JackLiu00331/CDRLCArduino/(commit log)

2026-04-24 Initial commit: reorganize project into src/ layout
    - src/Arduino/{master_node,ui_node,wing_a,wing_b} – Arduino sketches
    - src/server/ – Python room server and utilities
    - src/docker/ – Dockerfile, docker-compose, nginx, Tailscale config
    - src/test/ – I2C ping tools and integration test sketches
    - src/ – PDF milestone report
    - Root – README.md, CDRLC_Final_Report.md, .gitignore
2026-04-24 feat: add 16x2 LCD fallback master node (v5.1-LCD)
    Adds src/Arduino/master_node_lcd/master_node_lcd.ino as a
    development/fallback build while the Hosyond 4" TFT screen is
    not yet available.
    Functional parity with TFT v5.0:
    - Same WiFi + HTTPS server polling (5-min auto, BTN2 manual)
    - Same I2C master: Wing A (0x09), Wing B (0x0A), DHT11 (0x08)
    - Same 3-button control: slot cycle / refresh / date cycle
    - Same non-blocking buzzer alert on room-becomes-free
    Display differences (16x2 LCD, no touch, no QR):
    - Line 1: "MM/DD HHMM ##.#C" (date, slot, temperature)
    - Line 2: auto-cycles 4 pages of 2 rooms every 2.5 s
    e.g. "2432:F 2434:B "
    LCD pins: RS=D7, EN=D9, D4=D10, D5=D11, D6=D12, D7=D13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
    [master_node_lcd.ino]
2026-04-24 fix: slot cache, today snapshot, and weekend date expansion
    Fix 1 – Arduino local slot cache (master_node + master_node_lcd):
    • Add cachedSlots[5][8][9] + slotCached[5][8] arrays
    • Extract applySlotData() to share LED/display update logic
    • fetchAndDisplay() checks cache first; only fetches from server on miss
    • lastAutoFetch timer only resets on real network fetch (not cache hits)
    • BTN2 clears entire cache before /refresh so all slots re-fetch fresh
    • Auto-refresh invalidates current slot only; other slots stay instant
    • fetchDates() clears cache whenever date list is rebuilt
    Fix 2 – Server day snapshot (room_server.py):
    • After each refresh_all(), save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
    [master_node.ino, master_node_lcd.ino, ui_node.ino]
2026-04-24 ux: add loading indicators to LCD build (v5.1-LCD)
    - Show "MM/DD HHMM ..." + "Fetching data..." on cache miss before
    blocking HTTP call so user knows the screen is working, not frozen
    - Show "Network error!" for 1.5 s on HTTP failure then restore data
    - BTN2 (manual refresh): also update line 1 to "Please wait..."
    - pendingRefresh wait: show "Getting dates..." before fetchDates()
    - lcdPageTick() frozen during pendingRefresh to avoid overwriting messages
    - setup(): show "Getting dates..." before first fetchDates() call
    [master_node_lcd.ino]
2026-04-24 ux: add loading indicators and error states to TFT build (v5.0)
    - Add drawHeaderWithBadge(): redraws header with custom status badge
    (e.g. "loading...", "refreshing...", "error!") while keeping date/slot
    context visible — user always knows what they are waiting for
    - Add drawContentStatus(): fills only the room-list area with a centred
    big+small message; header stays untouched
    - Cache miss → drawHeaderWithBadge("loading...")+drawContentStatus before
    blocking HTTP call so screen never silently freezes
    - Network error → dark-red overlay "Network Error / Showing last known data"
    for 2 s, then restore previous room data via drawNormalScreen()
    - BTN2: show "Refreshing from server.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
    [master_node.ino]
2026-04-25 fix: correct TFT driver IC from ST7796S to ILI9486
    Display is Hosyond 4.0" with ILI9486 (not ST7796S as previously assumed).
    Key User_Setup.h changes that affect hardware behaviour:
    - #define ILI9486_DRIVER (was ST7796_DRIVER)
    - TFT_RGB_ORDER TFT_BGR (ILI9486 sends Blue before Red; ST7796S was RGB)
    - SPI_FREQUENCY 20000000 (lowered from 27 MHz; ILI9486 SPI more conservative)
    - Added #define TFT_INVERSION_ON note for modules with inverted display
    Also updated all references in master_node.ino, master_node_lcd.ino,
    README.md, and CDRLC_Final_Report.md (driver name + datasheet attribution).
    [User_Setup.h, master_node.ino, master_node_lcd.ino]
2026-04-25 revert: restore ST7796S driver (ILI9486 was incorrect)
    Reverts commit e2927e5. The display is confirmed ST7796S, not ILI9486.
    Restores User_Setup.h to ST7796_DRIVER, SPI 27 MHz, TFT_RGB colour order,
    and updates all comments and documentation references accordingly.
    [User_Setup.h, master_node.ino, master_node_lcd.ino]
2026-04-25 fix: persist day_snapshot.json across container rebuilds
    Add volume mount for day_snapshot.json so the date snapshot
    data survives docker compose up --build. Without this, the
    server loses all cached future-date availability on every
    image rebuild and must wait for the next refresh cycle.
    Requires creating an empty file on the host before first run:
    echo "{}" > day_snapshot.json
2026-04-25 fix: QR generation failure and flicker on TFT build
    - Bump QR version 9 → 10 (byte capacity 154 → 174); our ~140-char
    Google Calendar URLs were at the edge of V9's limit under stack
    pressure from SSL/TFT SRAM usage on the R4 WiFi
    - Declare qrData[] as static (global memory) instead of a local stack
    variable to avoid stack overflow when WiFi+TFT already fill SRAM
    - On generation failure: show a readable 2-second error message, then
    reset dispState to DISP_NORMAL and call drawNormalScreen() — prevents
    the flicker loop where every subsequent touch re-triggered drawQRScreen
    [master_node.ino]
2026-04-25 fix: touch flicker between QR and Normal screens
    Add touchMustRelease flag: after any QR↔Normal state transition, all
    touch events are ignored until ts.touched() returns false (finger lifted).
    Previously, a single tap could fire two actions in quick succession:
    1. touch in Normal mode → dispState=DISP_QR (drawQRScreen renders)
    2. same finger still down → fires again in DISP_QR → dispState=DISP_NORMAL
    3. same finger still down → fires again at 479,319 which maps to row 7
    (Room 2430) → dispState=DISP_QR again → infinite flicker loop
    The wait-for-release approach is more robust than a simple cooldown because
    it is independent of rendering time and screen response late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
    [master_node.ino]
2026-04-25 fix: replace direct Google URL QR with server short-link QR
    The qrcode library consistently failed to generate Version 10 QR codes
    for our ~140-char Google Calendar URLs on the R4 WiFi (likely a memory
    or library-version limitation that is hard to diagnose without the exact
    installed library source).
    New approach: use the server's existing /newbook + /b/<CODE> short-link
    infrastructure instead of encoding the full Google URL directly.
    Flow:
    1. User taps a free room row
    2. drawQRScreen() shows "Getting booking link..." loading screen
    3. Arduino calls GET /newbook?date=...&time=...
    4. Server returns a 6-char code (e.g. "A1B2C3")
    5. Short URL built: https://<SERVER>/b/A1B2C3 (~45 c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
    [master_node.ino]
2026-04-25 fix: QR now uses Google Calendar URL directly with correct library return value
    Key fixes:
    - Reverted to direct GCAL_URLS[] encoding (no server /newbook call needed)
    - Fixed root cause: ricmoo qrcode_initText returns 0 on success (C convention),
    not 1; casting to bool was inverting the result, causing false failures
    - Use qrc.size > 0 as the reliable success check instead of return value
    - QR Version 7 (45x45, 154-byte ECC_LOW capacity) handles ~140-char URLs
    - Added button debug logging: BTN1/D4 logs slotIdx change, BTN3/D6 logs dateIdx
    - QR renders instantly (no network round-trip)
    [master_node.ino]
2026-04-25 feat: today's date shows snapshot data without Book button; fix Friday date list
    Server (room_server.py):
    - valid_dates() now splits Fri vs Sat-Sun:
    Fri → [today (snapshot), next Mon–Thu] (5 dates, fits dateList[5])
    Sat-Sun → [next Mon–Fri] (unchanged)
    Mon-Thu unchanged (today through Fri of this week)
    Arduino (master_node.ino):
    - Added todayDate[9] global, computed from NTP epoch after WiFi connect
    - drawNormalScreen(): today's free rooms show "Free" (accent green, no pill)
    instead of "Book >" — visually distinguishable, not interactive
    - handleTouch(): tapping a room row is ignored when showing today's date,
    preventing a useless QR for a slot that Google Calendar wil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
    [master_node.ino]
2026-04-25 feat: prefetch all dates×slots at startup for instant navigation
    - Add GET /allslots?date=YYYYMMDD endpoint
    Returns all 8 slot strings comma-separated in one response (~71 chars)
    e.g. "10010100,11111111,00000000,..."
    5 requests covers all 40 slots (vs 40 individual /slot calls before)
    - Add prefetchAllDates(): fetches /allslots for every available date,
    parses and fills cachedSlots[d][s] + slotCached[d][s] for all d,s
    Shows "Mon 04/27 (1/5)" progress overlay during load
    Resets lastAutoFetch timer on completion
    - setup(): call prefetchAllDates() after fetchDates(); fetchAndDisplay()
    is then always a cache hit — no post-boo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
    [master_node.ino]
2026-04-25 fix: always consume HTTP response body to keep keep-alive connection clean
    httpGet() was returning early on non-200 status without reading the body.
    This left stale bytes in the SSL socket, corrupting the next request on
    the same keep-alive connection (manifested as Network Error on /slot after
    multiple failed /allslots 404 responses from an outdated server image).
    Now always reads responseBody() before checking status code.
    [master_node.ino]
2026-04-25 refactor: remove unused booking session code from room_server.py (v4.2)
    Arduino now generates QR codes directly from hard-coded Google Calendar URLs,
    so the entire server-side booking flow is no longer needed.
    Removed:
    - import secrets
    - BOOK_BASE_URL constant
    - GCAL_BOOK_URLS dict (URLs now live only in Arduino flash)
    - booking_sessions dict + sessions_lock + SESSION_TTL
    - make_code() and cleanup_sessions() helpers
    - booking_page_html() function (~90 lines of HTML template)
    - /newbook endpoint (Arduino no longer calls it)
    - /b/<CODE> endpoint (phone booking page removed)
    - reply_html() method (only used by /b/<CODE>)
    Kept:
    - /hotslots + get_hot_slots() (used by /status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
2026-04-25 fix: validate date and time parameters in slot request
2026-04-25 fix: allow /allslots through nginx and harden date validation
    - nginx.conf: add allslots to the location regex so requests reach
    the Python server (was 404'd before). Also remove the now-deleted
    newbook and b/.+ routes.
    - room_server.py: add .isdigit() guard on /allslots date param,
    matching the same validation already on /slot.
2026-04-25 feat: move HC-SR04 to master_node for TFT backlight auto-dim
    - master_node: add HC-SR04 on D2(Trig)/D7(Echo), TFT backlight on
    D3(PWM). updateBacklight() checks distance every 200ms — dims screen
    to 30/255 when no one within 100cm, restores 255 when someone approaches.
    - wing_b: remove HC-SR04 entirely (sensor now lives on master_node).
    LEDs run at fixed brightness 200. Simplifies wing_b significantly.
    [master_node.ino, wing_b.ino]
2026-04-26 feat: activity-based backlight with smooth fade and auto-off
    Replace simple on/off proximity backlight with a proper idle timer:
    - Any activity (proximity / touch / button) → immediate full brightness
    and resets the 30-second idle clock.
    - 10–13 s idle: smooth 3-second linear fade to dim (40/255).
    - 13–30 s idle: hold at dim — screen readable but unobtrusive.
    - 30 s+ idle: screen off completely (0/255).
    - Touch while screen is off: wake only, no booking action triggered.
    [master_node.ino]
2026-04-26 feat: add TM1637 4-digit + 74HC595 1-digit displays on Arduino 2
    ui_node (Arduino 2):
    - TM1637 4-digit display on D3/D4 shows current time slot (e.g. 09:30)
    with colon lit. Bit-banged driver, no extra library needed.
    - 74HC595 + 1-digit 7-seg on D5/D6/D7 shows free room count (0-8).
    - New Wire.onReceive() handler accepts 2-byte packet [freeCount, slotIdx]
    from master and updates both displays immediately.
    - Startup shows "----" / "-" until first data arrives from master.
    - DHT11 read and I2C requestEvent unchanged.
    master_node (Arduino 1):
    - New sendDisplayData(): counts free rooms from roomFree[], then sends
    [freeCount, slotIdx] to Arduino 2 (0x08) via I2C write.
    - Called at the end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
2026-04-26 fix: update 7-seg driver for 5161AS common-anode display
    - SEG7[] patterns inverted (active-low for common anode)
    - shiftOut changed from MSBFIRST to LSBFIRST so bit0→QA→segment-a
    - Startup dash corrected to 0xBF (~0x40, g-segment only)
    - Wiring comment updated: COM pins → 5V, each segment → 220Ω → QA-QG
    [ui_node.ino]
2026-04-26 refactor: remove TM1637, keep only 5161AS 1-digit display
    Space only allows one 7-seg. Free room count (0-8) gives more
    at-a-glance value than time slot which is already on the TFT.
    Simplifies ui_node: no TM1637 pins/driver/slot-digit table.
2026-04-26 refactor: drive 5161AS directly without 74HC595
    ui_node has plenty of free pins — no shift register needed.
    7 segment pins connect directly to D3-D9 via 220Ω resistors.
    Code simplifies to plain digitalWrite(), no shiftOut().
2026-04-26 fix: switch 7-seg to common cathode (COM→GND, segments active-HIGH)
    [ui_node.ino]
2026-04-26 feat: centralize LDR to master_node, broadcast brightness to all 8 LEDs
    - master_node: read LDR on A2 each loop tick, cache as ledBrightness.
    sendI2C() extended from 3 to 4 bytes: [ctrl, data, brightness, checksum].
    - wing_a: remove local LDR. receiveEvent() now reads 4-byte packet and
    stores brightness from master. All 5 LEDs use master-controlled brightness.
    - wing_b: same 4-byte protocol. All 3 LEDs now follow ambient light instead
    of fixed value 200.
    All 8 LEDs across both wings now dim/brighten identically.
    [master_node.ino, wing_a.ino, wing_b.ino]
2026-04-26 calibrate: adjust LDR map range to measured values (102–850)
    Based on actual hardware readings:
    102 = finger pressed (darkest) → LED brightness 40
    375 = dim bedroom → LED brightness ~120
    850 = flashlight direct → LED brightness 255
2026-04-26 feat: LEDs follow screen sleep state + remove debug logs
    - sendI2C() now sends brightness=0 when screen is BL_OFF, so all wing
    LEDs go dark when the 30s idle timer fires (same moment as screen off).
    - markActive() resends current status to both wings immediately on wake,
    so LEDs and screen light up together on any activity.
    - Periodic 1s brightness sync renamed lastBrightnessSync (was lastLDRPrint).
    - Removed all test Serial.print logs from wing_a, wing_b receiveEvent.
    - Removed Serial.begin(9600) from wing_a and wing_b setup.
2026-04-26 fix: turn off red LEDs when brightness=0 (sleep mode)
    Red LEDs use digitalWrite so they ignore the brightness value.
    When master sends brightness=0 (screen off), explicitly drive all
    red pins LOW so every LED goes dark during sleep.
    [wing_a.ino, wing_b.ino]
2026-04-26 fix: correct formatting in comments for Wing B LEDs address
    [master_node.ino]
2026-04-26 docs: finalize all comments and update documentation to match current hardware
    - Rewrite all .ino file headers to English with team member info; remove
    all Chinese text and decorative ===/--- style dividers
    - Reflect centralized LDR (master A2) and HC-SR04 (master D2/D7):
    Wing A and Wing B comments updated accordingly
    - Document 4-byte I2C protocol (ctrl, status, brightness, checksum)
    and brightness=0 LED sleep behavior in all relevant files
    - Add 5161AS 7-segment wiring and description to ui_node comments
    - Update CDRLC_Final_Report.md: team members, sections 2/3/4/5/7,
    materials list, wiring tables, test checklist, design decisions
    - Update README.md: features table, hardware table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
